lenzseg/esp32-mini-dev-board/docs/images/transmission-line-90ohms.png

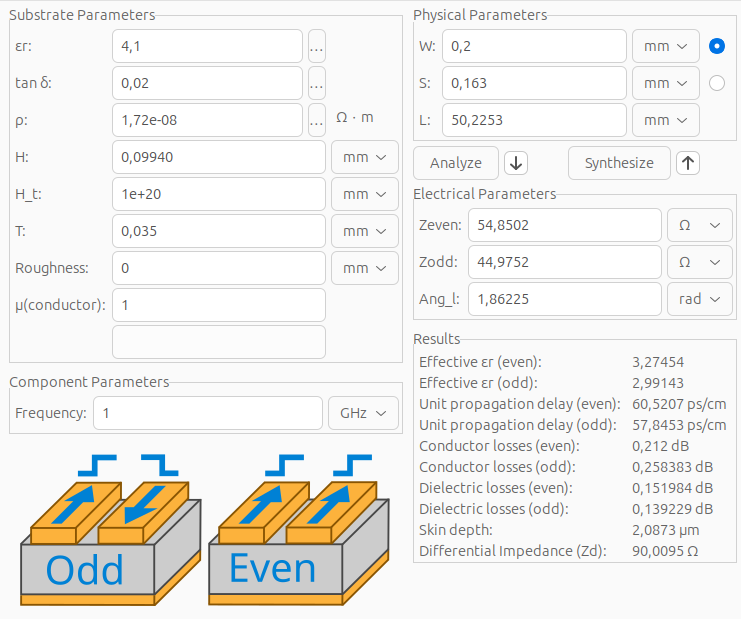
docs/images/transmission-line-90ohms.png
