lenzseg/esp32-mini-dev-board/src/esp32-mini-dev-board.kicad_pcb

## KiCad design src/esp32-mini-dev-board.kicad_pcb (2026-10-23)

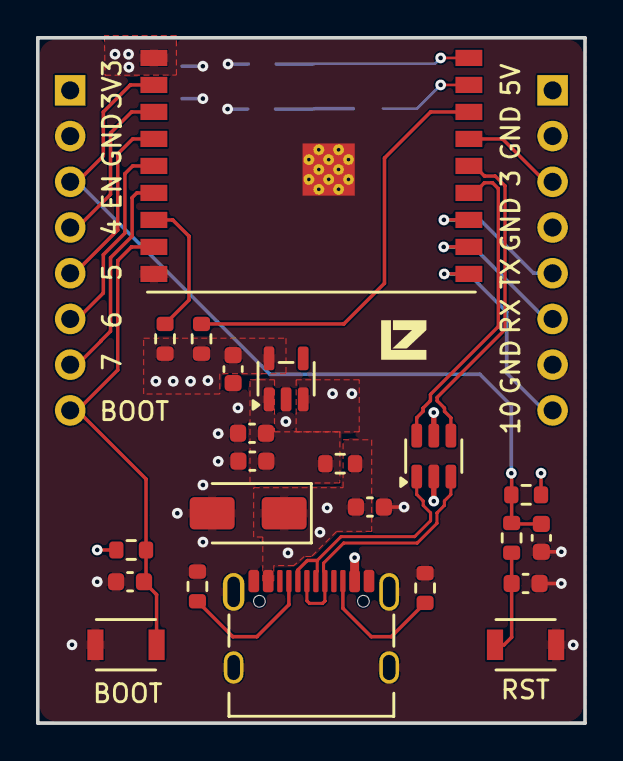
[picture p3: board esp32-mini-dev-board.kicad_pcb from above]

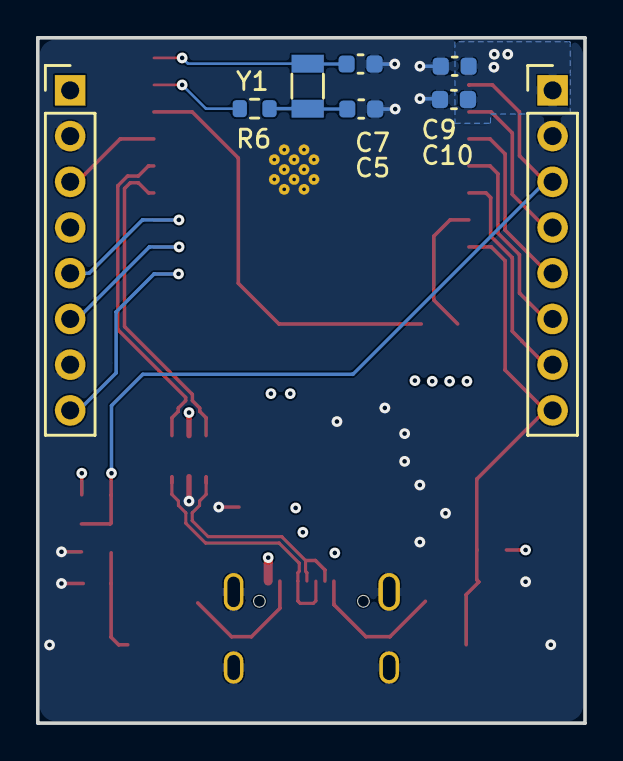
[picture p4: board esp32-mini-dev-board.kicad_pcb from below]

Board: 4 copper layers, 30.4 x 38.1 mm, 30 parts (8 on the bottom side), 26 nets.

Parts:
C1, C2, C3, C4, C6, C8, C9, C11: 4.7uF; C_0603_1608Metric
C5, C7, C10: C; C_0603_1608Metric
D1: SMAJ5.0A; D_SMA
J1: USB_C_Receptacle_USB2.0_16P; USB_C_Receptacle_G-Switch_GT-USB-7010ASV
J2, J3: Conn_01x08_Pin; PinHeader_1x08_P2.54mm_Vertical
R1, R2, R3, R4, R5, R6, R7, R8, R9: R; R_0603_1608Metric
SW1, SW2: SW_Push; SW_SPST_B3U-1000P
U1: USBLC6-2SC6; SOT-23-6
U2: AP2112K-3.3; SOT-23-5
U3: ESP32-C3-WROOM-02
Y1: 32.768kHz; Crystal_SMD_3215-2Pin_3.2x1.5mm

Connections:
+3V3: C8.1, C9.1, C10.1, J2.1, R4.1, R7.1, R8.1, R9.1, U2.5 (VOUT), U3.1 (3V3)
+5V: C4.1, C6.1, J3.1, R5.2, U2.1 (VIN), U2.3 (EN)
/CIRCUIT DESIGN/BOOT: C11.1, J2.8, R9.2, SW2.2, U3.8 (IO9)
/CIRCUIT DESIGN/EN: C3.1, J2.3, R3.2, R4.2, U3.2 (EN)
/CIRCUIT DESIGN/IO3: J3.3, U3.15 (IO3)
/CIRCUIT DESIGN/IO4: J2.4, U3.3 (IO4)
/CIRCUIT DESIGN/IO5: J2.5, U3.4 (IO5)
/CIRCUIT DESIGN/IO6: J2.6, U3.5 (IO6)
/CIRCUIT DESIGN/IO7: J2.7, U3.6 (IO7)
/CIRCUIT DESIGN/IO10: J3.8, U3.10 (IO10)
/CIRCUIT DESIGN/RXD: J3.6, U3.11 (IO20/RXD)
/CIRCUIT DESIGN/TXD: J3.5, U3.12 (IO21/TXD)
/CIRCUIT DESIGN/USB_D+: U1.4 (I/O2), U3.14 (IO19)
/CIRCUIT DESIGN/USB_D-: U1.6 (I/O1), U3.13 (IO18)
/CIRCUIT DESIGN/USB_IN+: J1.A6 (D+), J1.B6 (D+), U1.3 (I/O2)
/CIRCUIT DESIGN/USB_IN-: J1.A7 (D-), J1.B7 (D-), U1.1 (I/O1)
/CIRCUIT DESIGN/VBUS: C2.1, D1.1 (A1), J1.A4 (VBUS), J1.A9 (VBUS), J1.B4 (VBUS), J1.B9 (VBUS), R5.1, U1.5 (VBUS)
/CIRCUIT DESIGN/XTAL_32K_N: R6.2, U3.17 (IO1)
/CIRCUIT DESIGN/XTAL_32K_P: C5.1, U3.18 (IO0), Y1.1
GND: C1.2, C2.2, C3.2, C4.2, C5.2, C6.2, C7.2, C8.2, C9.2, C10.2, C11.2, D1.2 (A2), J1.A1 (GND), J1.A12 (GND), J1.B1 (GND), J1.B12 (GND), J1.SH (SHIELD), J2.2, J3.2, J3.4, J3.7, R1.2, R2.2, SW1.1, SW2.1, U1.2 (GND), U2.2 (GND), U3.9 (GND), U3.19 (GND)
unnamed: C1.1, R3.1, SW1.2
unnamed: C7.1, R6.1, Y1.2
unnamed: J1.A5 (CC1), R2.1
unnamed: J1.B5 (CC2), R1.1
unnamed: R7.2, U3.16 (IO2)
unnamed: R8.2, U3.7 (IO8)
