lenzseg/esp32-mini-dev-board/(commit log)

2026-10-22 feat: create KiCad project
    [esp32-mini-dev-board.kicad_pcb, esp32-mini-dev-board.kicad_sch]
2026-10-22 feat(arch): add top-level block diagram sheet
    [block-diagram.kicad_sch, esp32-mini-dev-board.kicad_sch]
2026-10-22 feat(sch/pwr): add usb power entry circuit
    [circuit-design.kicad_sch]
2026-10-22 feat(sch/pwr): add 3.3V LDO regulation circuit
    [circuit-design.kicad_sch]
2026-10-22 feat(sch/mcu): add mcu and auxiliary circuits
    There were added the fundamental MCU circuits:
    - Power conditioning
    - Boot
    - Reset/Enable (is the same for ESP32 MCUs)
    - Clock
    [circuit-design.kicad_sch, esp32-mini-dev-board.kicad_pcb]
2026-10-22 feat(sch/io): add gpio expansion headers
    In addition to access the IO ESP32 pins, excluding strapping pins (IO2, IO8), USB data lines (IO18, IO19) and XTAL pins (IO0, IO1), there are also included +5V and +3V3 and 3 extra GND pins.
    [circuit-design.kicad_sch]
2026-10-22 feat(lay): add first placement of all parts
    [circuit-design.kicad_sch, esp32-mini-dev-board.kicad_pcb]
2026-10-22 feat(lay): modify placement and first pre-routing
    [circuit-design.kicad_sch, esp32-mini-dev-board.kicad_pcb]
2026-10-22 feat(lay/pwr): add +3V3 power zones in F.Cu
    - Design rules were set to meet the JLCPCB manufacturing capabilities.
    - The +5 and VBUS power zones in F.Cu were fixed to pass DRC.
    - Vias for GND, +5V, +3V3 and VBUS were added.
    [esp32-mini-dev-board.kicad_pcb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]
2026-10-22 feat(lay/mcu): add copper zones to connect +3V3 pads to bypass capacitors
    [esp32-mini-dev-board.kicad_pcb]
2026-10-22 feat(lay/usb): add differential pair tracks
    The JLCPCB stackup was modified to allow thinner differential tracks.
    [circuit-design.kicad_sch, esp32-mini-dev-board.kicad_pcb]
2026-10-22 feat(lay/osc): add xtal oscillator circuit
    The USB differential pair was redrawn to ensure symmetrical traces length.
    [esp32-mini-dev-board.kicad_pcb]
2026-10-22 feat(lay): finish routing and copper pouring
    [circuit-design.kicad_sch, esp32-mini-dev-board.kicad_pcb, esp32-mini-dev-board.kicad_sch]
2026-10-22 feat(lay): add silkscreen labels for IOs and power pins
    [esp32-mini-dev-board.kicad_pcb]
2026-10-22 feat(sch/usb): add MPN for bypass and filter capacitors, push buttons, LDO, ESD protection
    [circuit-design.kicad_sch]
2026-10-22 fix(lay): make several changes to pass JLCDFM tool check
    - Copper zones were resize.
    - Vias were shifter to avoid silkscreen graphical objects and text interference.
    - Keep out zones were added to remove JLCDFM bug in soldermask expansion rule.
    - Headers were moved away headers from ESP32-C3 module to pass tht-smt rule.
    [esp32-mini-dev-board.kicad_pcb]
2026-10-22 feat(sch/usb): replace caps and res with own database parts.
    Capacitors and resistors were replaced with those in my own database.
    [esp32-mini-dev-board.kicad_sch]
2026-10-22 refactor(sch/usb): replace circuit protection devices symbols with own database symbols
    [block-diagram.kicad_sch, circuit-design.kicad_sch, esp32-mini-dev-board.kicad_pcb, esp32-mini-dev-board.kicad_sch]
2026-10-23 feat(sch): add MPN for RPUs and R filter
    [circuit-design.kicad_sch, esp32-mini-dev-board.kicad_pcb]
